microrack/VCO/README.md

# VCO
Voltage controlled oscillator module for microrack
