microrack/VCO/(threads)

Thread 1 (2019-03-15):

Change detune sensitivity

aanper, 2019-03-15:
I want to change detune series resistor to 470k because too hard to find correct pitch now.
But @sntxerror want to pitch down any note he playing.
Maybe add two detune knob (fine/coarse).

glitchcore, 2020-11-01:
Add two knob

Thread 2 (2019-03-15):

Remove "tune 2" trim

aanper, 2019-03-15:
No need to use tune2 because it has same effect as detune adjust.
We need to measure best value and change trimmer to fixed resistor.

Thread 5 (2020-11-01):

Задачи по версии 0.2

glitchcore, 2020-11-01:
## Исправить схему

* Добавить линейные регуляторы на ±5 В
* Заменить Q1/Q2 на сдвоенный транзистор (подобрать компонент)

Текущее состояние схемы лежит в ветке `vco-a`: готова схема (кроме вышеуказанных замечаний), расставлены компоненты.

## Переделать рэк
Также я уменьшил расстояние между крепежными гребенками, нужно согласовать с рэком (изменить расстояние там).

## Развести

Стараться компоненты распологать с обратной стороны.

Krasnov-Max, 2020-11-02:
ok. Task finished

Closed 2020-11-02.

Thread 7 (2020-11-02):

Выровнять разъемы и изменить количество PLS

sntxerror, 2020-11-02:
Расположить крепежные отверстия на одинаковом расстоянии от краев модуля, максимально широко

Расположение PLS для модулей:

cверху
```
. . . .    . . . .
```

снизу
```
 . . .      . . .
. . . .    . . . .
```

Krasnov-Max, 2020-11-05:
Диаметр крепежных отверстий? И можно ли увеличить габариты модуля по оси X?

Krasnov-Max, 2020-11-06:
add moutig hole. Chenge position power connectors. This issue cloased.

Closed 2020-11-06.

Thread 8 (2020-11-03):

Добавить индикаторные светодиоды

glitchcore, 2020-11-03:
Рядом с выходами saw и sq добавить по одному светодиоду (с внутренней стороны)
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

Подключить к выходам через 1к
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

Krasnov-Max, 2020-11-04:
Давай придем к тому что стороны на плате называем верхняя (top) где расположены регуляторы, и нижняя (bottom) где расположены разъемы питания.

glitchcore, 2020-11-05:
Под внутренней стороной я понимал расположение светодиодов относительно контура платы (в центре)

Closed 2020-11-05.
