microrack/VCO/(commit log)

2019-03-15 move kicad from module repository
    [VCO.kicad_pcb, VCO.sch]
2019-03-15 add 0.1 prototype from module repository
    [VCO.dch, VCO.dip]
2019-03-31 copy from legacy repo
    [VCO.kicad_pcb, VCO.sch]
2019-04-05 Изменены УГО резисторов с европейского обозначения на Российский Исправленны пути к библиотекам
    [VCO.kicad_pcb, VCO.sch]
2019-04-10 Плата 40х70 мм. Добавленны подписи компонентов и регуляторов Косметические изменения в схеме, уменьшенно количество разъемов питания
    [VCO.kicad_pcb, VCO.sch]
2020-11-01 Change schematics: Q1 and Q2 to Double NPN Q1A and Q1B Add component to PCB
    [VCO.kicad_pcb]
2020-11-02 Make PCB.
    [VCO.kicad_pcb, VCO.sch]
2020-11-02 remove diptrace files
    [VCO.dch, VCO.dip]
2020-11-02 Add lenear voltage regulator Make PCB new color render pcb add new component to librarry project
    [VCO.kicad_pcb, VCO.sch]
2020-11-02 Change GND to GNDREF in schematics
    [VCO.kicad_pcb]
2020-11-03 use power symbols from urack library, specify LDO caps
    [VCO.sch]
2020-11-03 move logo and label
    [VCO.kicad_pcb]
2020-11-03 change square-wave output divider
    [VCO.sch]
2020-11-03 Edeting .gitignore
    [VCO.kicad_pcb, VCO.sch]
2020-11-04 fix lib again
    [VCO.sch]
2020-11-05 Add led's. Issue #8 close
    [VCO.kicad_pcb, VCO.sch]
2020-11-06 Change position power connector add mounting hole 3.2 mm diametr Issue #7 closed
    [VCO.kicad_pcb, VCO.sch]
2020-11-07 Change position power connector delete mounting hole
    [VCO.kicad_pcb]
2020-11-10 Change position power conectors.
    [VCO.kicad_pcb]
2020-11-21 Change current led's resistor 100R to 1K
    [VCO.sch]
2020-11-30 add power protection change power connector
    [VCO.kicad_pcb, VCO.sch]
2020-12-01 Chage conection transistor Q2 Resize PCB
    [VCO.kicad_pcb, VCO.sch]
2020-12-03 move label
    [VCO.kicad_pcb]
2020-12-03 Reconect Q2
    [VCO.kicad_pcb, VCO.sch]
2020-12-15 finish logo
    [VCO.kicad_pcb]
